camilomazo265/Turbia-Turgo/README.md

en este enlace se puede obtener el diseño en el que nos basamos. 
https://grabcad.com/library/turgo-turbine-runner-1
