camilomazo265/Turbia-Turgo/(list of files, cad)

Other CAD files:
Rodete.f3d
acople_T_reduccion.f3d
acople_manometro.f3d
acople_motor_turbina.f3d
tobera.f3d
